momos123/ODX/README.md

This repository contains all the files and instructions required to build the ODX device.
