momos123/ODX/BillofMaterials/BOM.pdf

Bill of materials for ODX

Part | Price per unit | Quantity | Total cost | Part No. | Supplier
Voltage Regulator | € 1.08 | 1 | $1.20 | TPS709B33D BVT | https://ie.farnell.com/
Current Regulator | € 0.388 | 1 | $0.42 | NSI45020AT1 G | https://ie.farnell.com/
LED | € 0.148 | 1 | $0.15 | C503B-AAN-CY0B0251 | https://ie.farnell.com/
ID107 HR fitness tracker | € 11 | 1 | $12.30 | ID107 | http://www.idoosmart.com/c2416.html (http://www.idoosmart.com/c2416.html)
Total cost | | | $14.07
