momos123/ODX/Openscad/ODX_device.stl

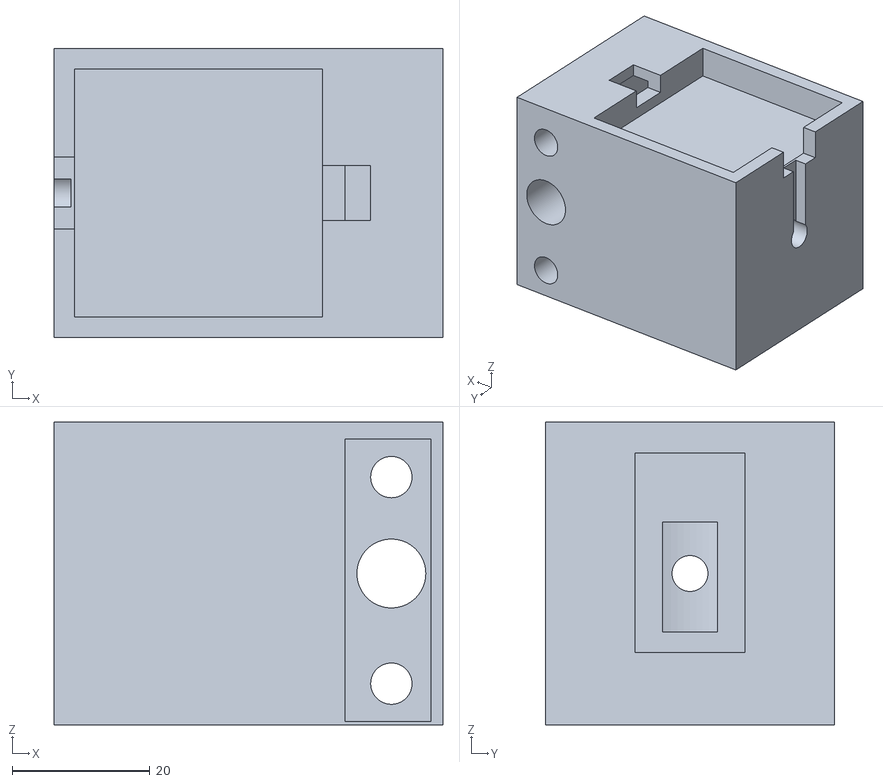
[picture p1: CAD file, 2019-07-20]
Openscad/ODX_device.stl
56.5 x 42.0 x 44.0
