momos123/ODX/Instructions/Instructions.pdf

## ODX - A fitness tracker-based device for continuous bacterial growth monitoring

V. V. B. Yallapragada¹,2, *, U. Gowda³,4, *, D. Wong¹, L O’Faolain³,4,5, M. Tangney¹,2,6 and G. C. R. Devarapu³,4,5, #
1. Cancer Research@UCC, University College Cork, Cork, Ireland.
2. SynBioCentre, University College Cork, Cork, Ireland.
3. Centre for Advanced Photonics and Process Analysis, Cork Institute of Technology, Cork, Ireland.
4. Tyndall National Institute, Cork, Ireland.
5. Scottish Universities Physics Alliance, School of Physics & Astronomy, St Andrews, UK.
6. APC Microbiome Ireland, University College Cork, Cork, Ireland. *Contributed equally to this work

#E-mail: chinna.devarapu@cit.ie

## Instructions to build ODX

A. Fitness tracker’s top view showing removable screws.

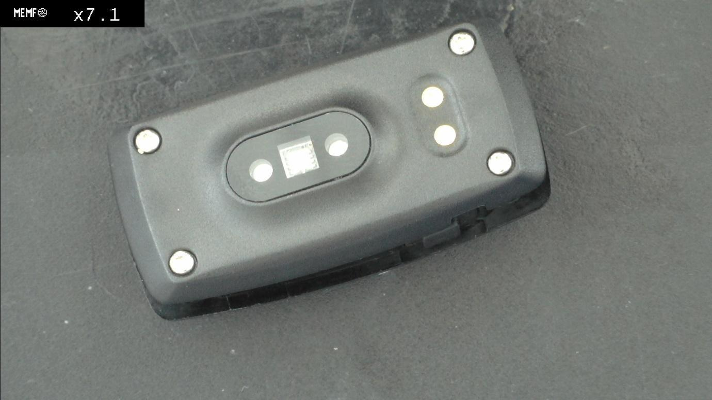
[picture p2: figure]

B. The device is opened with a 0.2mL hex head screwdriver to access the electronics embedded inside

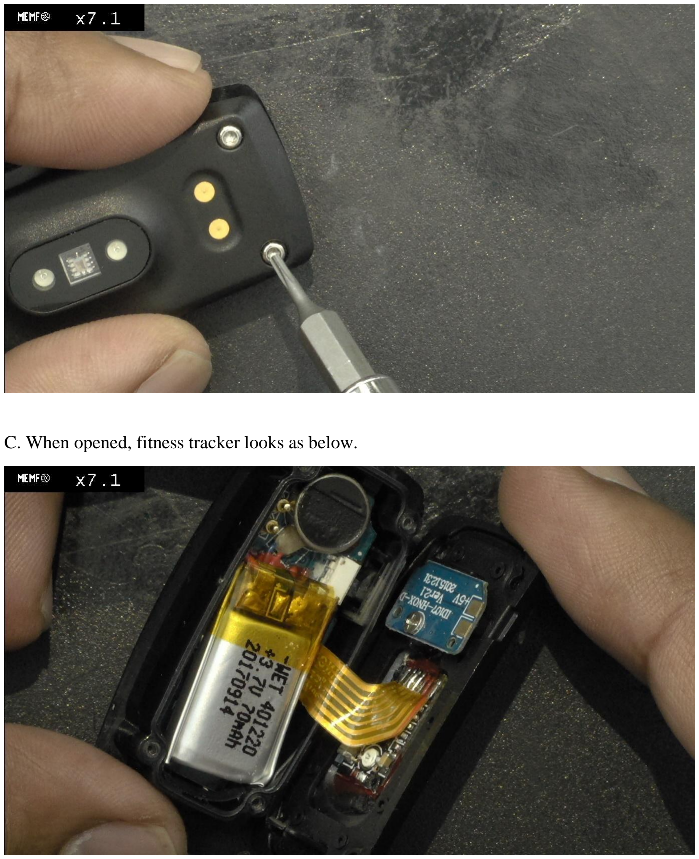
[picture p3: page 2]

C. When opened, fitness tracker looks as below.

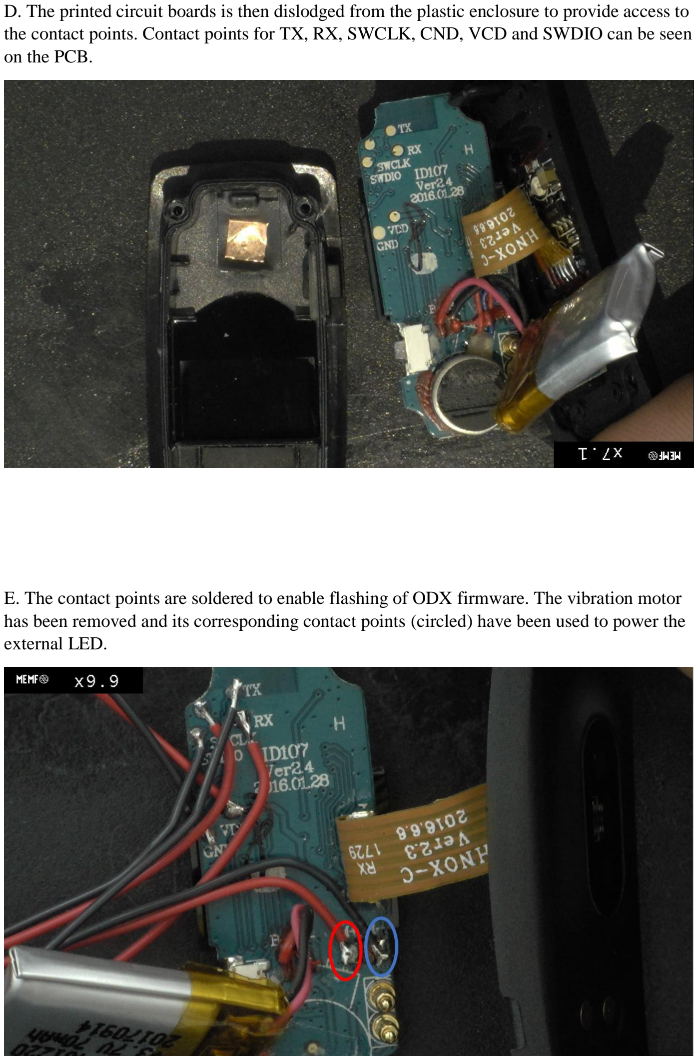
[picture p4: page 3]

D. The printed circuit boards is then dislodged from the plastic enclosure to provide access to the contact points. Contact points for TX, RX, SWCLK, CND, VCD and SWDIO can be seen on the PCB.
E. The contact points are soldered to enable flashing of ODX firmware. The vibration motor has been removed and its corresponding contact points (circled) have been used to power the external LED.

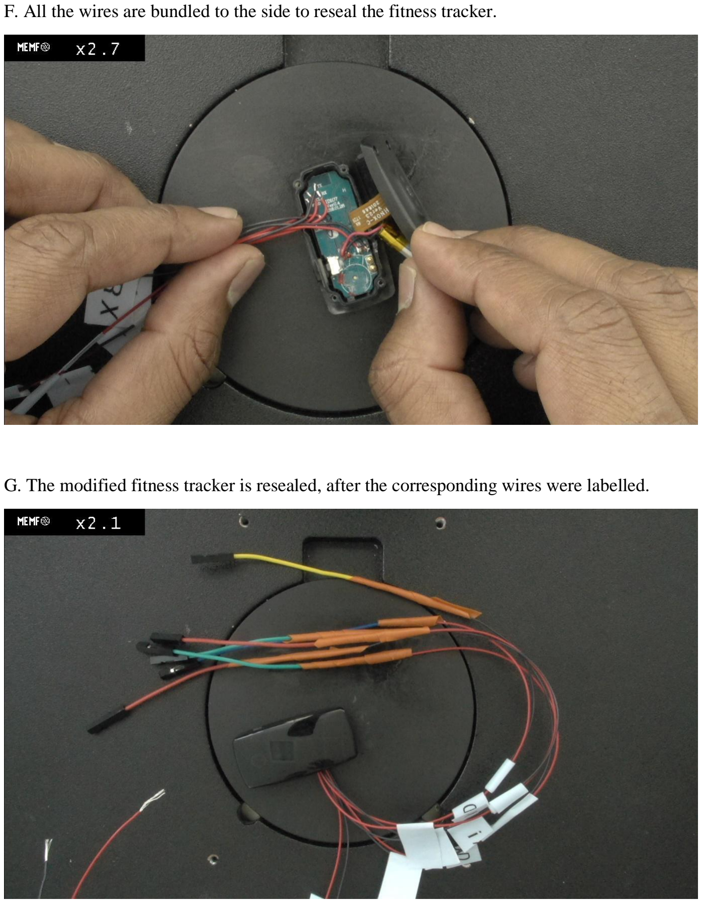
[picture p5: page 4]

F. All the wires are bundled to the side to reseal the fitness tracker.
G. The modified fitness tracker is resealed, after the corresponding wires were labelled.

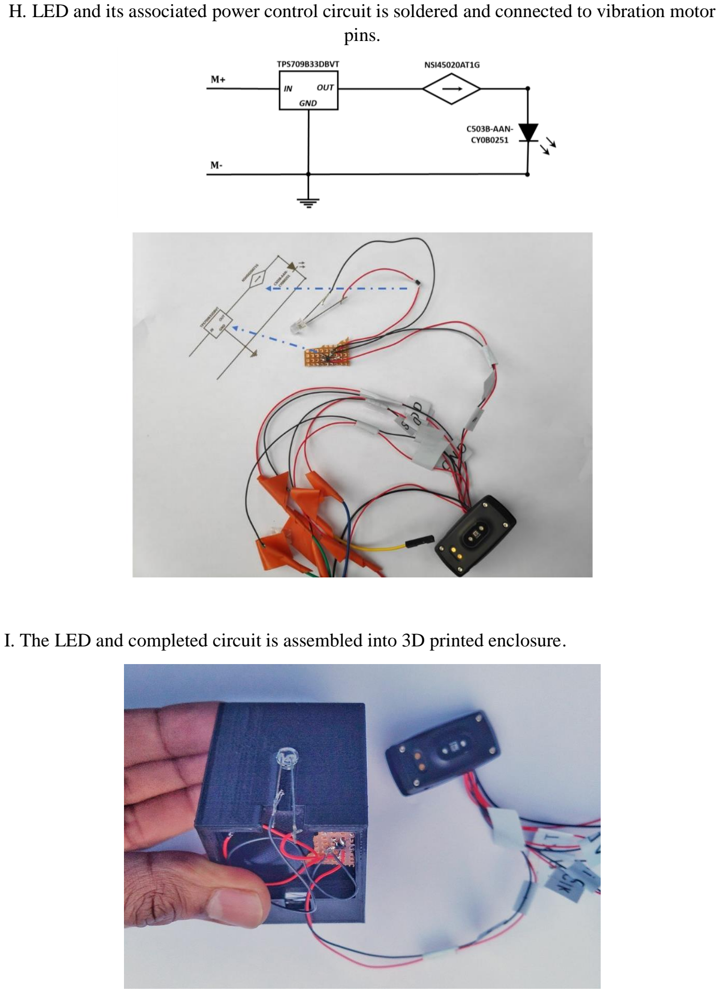
[picture p6: page 5]

H. LED and its associated power control circuit is soldered and connected to vibration motor pins.
I. The LED and completed circuit is assembled into 3D printed enclosure.

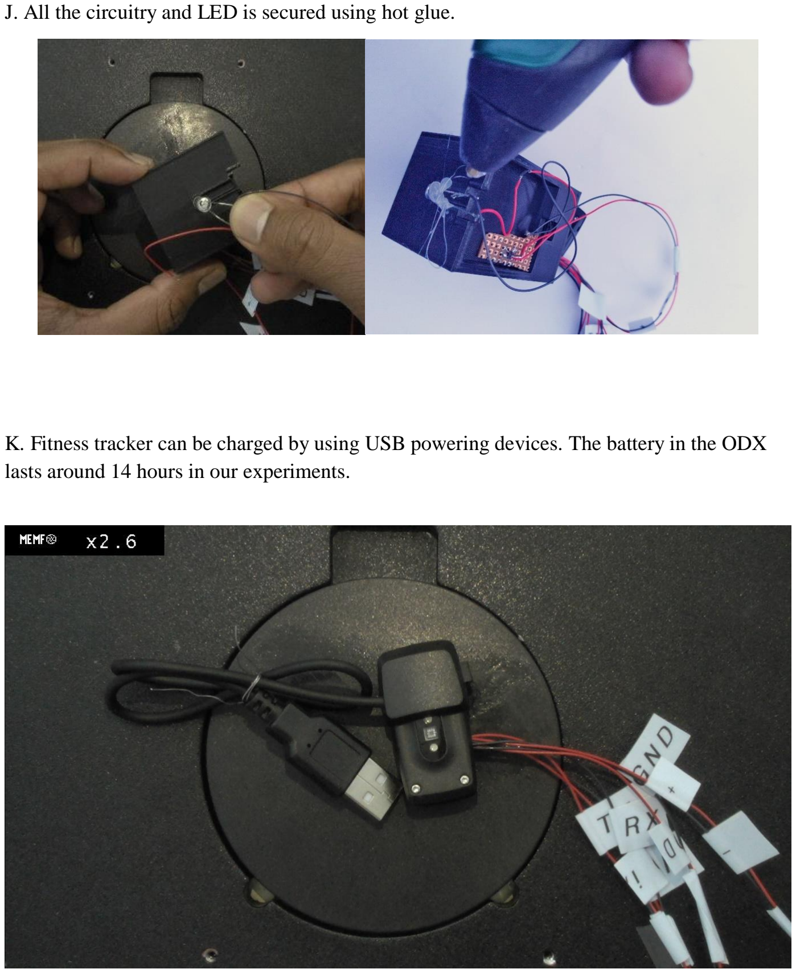
[picture p7: page 6]

J. All the circuitry and LED is secured using hot glue.
K. Fitness tracker can be charged by using USB powering devices. The battery in the ODX lasts around 14 hours in our experiments.

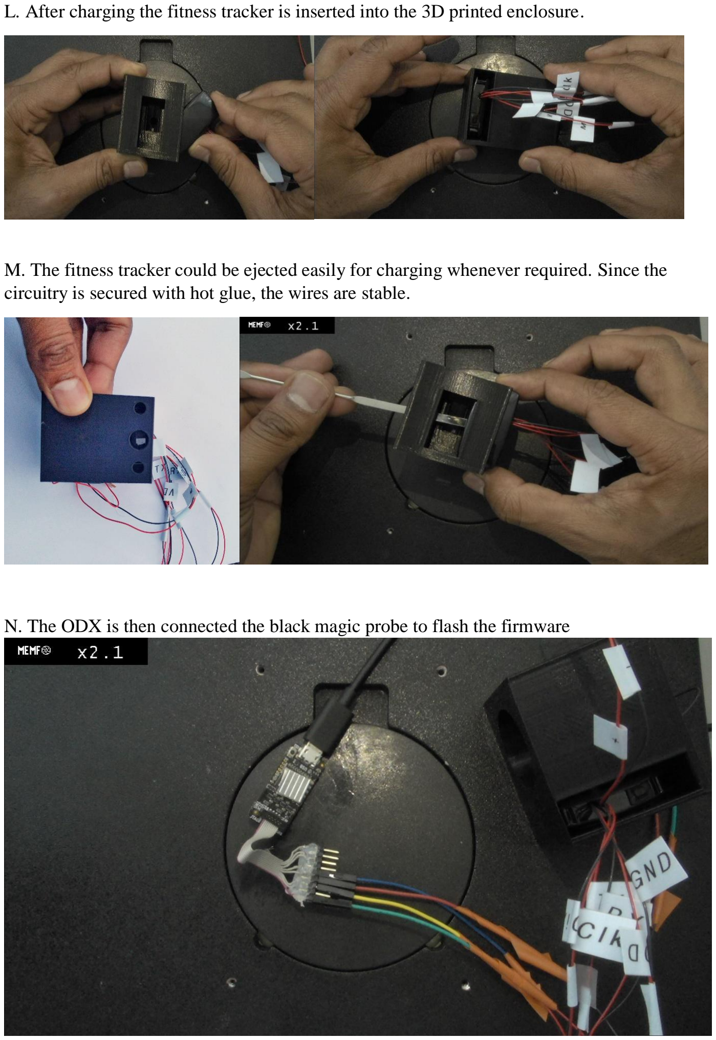
[picture p8: page 7]

L. After charging the fitness tracker is inserted into the 3D printed enclosure.
M. The fitness tracker could be ejected easily for charging whenever required. Since the circuitry is secured with hot glue, the wires are stable.
N. The ODX is then connected the black magic probe to flash the firmware

Firmware instructions for ODX

Note | that | these | instructions | are | taken | from | the | GitHub | repository
(https://github.com/sandeepmistry/arduino-nRF5) of sandeepmistry who originally provided the Arduino core for the nRF devices as stated in the ODX manuscript. Here, we provide the instructions of the firmware specifically adopted for the ODX device that contains nrf51 device using Windows PC.

Board Manager

a) Download and install the Arduino IDE (https://www.arduino.cc/en/Main/Software) (At least v1.6.12)
b) Start the Arduino IDE
c) Go into Preferences
d) Add | https://sandeepmistry.github.io/arduino-nRF5/package_nRF5_boards_index.json | as | an
"Additional Board Manager URL"
e) | Add | https://micooke.github.io/package_nRF5_smartwatches_index.jsonas an "Additional Board
Manager URL"
f) Open the Boards Manager from the Tools -> Board menu and install "Nordic Semiconductor nRF5 Boards"
g) Select ID107 HR from the Tools -> Board menu

Flashing a Soft Device

a) cd <SKETCHBOOK>, where <SKETCHBOOK> is your Arduino Sketch folder

(Windows: ~/Documents/Arduino)

b) Create the following directories: tools/nRF5FlashSoftDevice/tool/
c) DownloadbnRF5FlashSoftDevice.jar (https://github.com/sandeepmistry/arduino-nRF5/releases/download/tools/nRF5FlashSoftDevice.jar) | to
<SKETCHBOOK>/tools/nRF5FlashSoftDevice/tool/
d) Restart the Arduino IDE
e) Select your ID107HR from the Tools -> Board menu
f) Select a SoftDevice S130 from the Tools -> "SoftDevice: " menu
g) Select a Programmer (BMP) from the Tools -> "Programmer: " menu
h) Select Tools -> nRF5 Flash SoftDevice
i) Read license agreement
j) Click "Accept" to accept license and continue, or "Decline" to decline and abort
k) If accepted, SoftDevice binary will be flashed to the board

Flashing a ODX firmware

a) Download all the files from the from the firmware folder in the github link https://github.com/momos123/ODX/tree/master/firmware b) Open the ODX.ino with Arduino IDE
c) Select your ID107HR from the Tools -> Board menu
d) Select a SoftDevice S130 from the Tools -> "SoftDevice: " menu
e) Select a Programmer (BMP) from the Tools -> "Programmer: " menu
f) Select the BMP port as the Port on Arduino IDE
g) Upload the ODX.ino
